ymaksime/closetLights/PV/data/characterization_1ft.xlsx

Setting voltage to 10V |  |  | Setting voltage to 11V |  |  | Setting voltage to 12V |  |  | Setting voltage to 13V |  |  | Setting voltage to 14V
DAC | Voltage V | Current A | DAC | Voltage V | Current A | DAC | Voltage V | Current A | DAC | Voltage V | Current A | DAC | Voltage V | Current A
1 | 9.999905 | 6.56425 | 1 | 11.00186 | 6.84726 | 1 | 12.00024 | 6.81325 | 1 | 12.99995 | 6.774538 | 1 | 14.00065 | 6.663732
2 | 10.00004 | 14.15017 | 2 | 11.00087 | 14.35725 | 2 | 12.00038 | 14.34969 | 2 | 13.00039 | 14.290668 | 2 | 14.0015 | 14.224782
3 | 10.00084 | 22.17305 | 3 | 11.00172 | 22.46013 | 3 | 12.00029 | 22.22919 | 3 | 13.00066 | 22.396928 | 3 | 14.00043 | 22.195312
4 | 10.00053 | 29.82993 | 4 | 11.00163 | 30.09426 | 4 | 12.00056 | 29.99044 | 4 | 13.00017 | 30.114478 | 4 | 14.00146 | 29.952502
5 | 10.00022 | 38.06347 | 5 | 11.00181 | 38.2133 | 5 | 11.9998 | 38.05394 | 5 | 12.99999 | 38.070998 | 5 | 14.00141 | 37.843062
6 | 9.999995 | 45.52778 | 6 | 11.00096 | 45.88562 | 6 | 11.9993 | 45.86493 | 6 | 13.00035 | 45.795398 | 6 | 14.00105 | 45.907942
7 | 10.00022 | 53.59571 | 7 | 11.00146 | 53.54335 | 7 | 11.99953 | 53.59111 | 7 | 13.00044 | 53.682588 | 7 | 14.00083 | 53.537062
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
