ymaksime/closetLights/hardware/simulations/bjt_analysis.asc

Q1: npn
R1: res; 1; tol=1 pwr=0.1
R2: res; 10K
R3: res; {R}
V1: voltage; PULSE(0 3.3 1 0.5 0.5 1 4 1)
V2: voltage; 12
Named nets: 0
.tran 10
.step param R 200 2K 100
