ymaksime/closetLights/hardware/simulations/constant_current_driver.asc

Q1: npn; FMMT458
Q2: npn; 2SCR564F3
R1: res; 1; tol=1 pwr=0.25
R2: res; 10K; tol=1 pwr=0.063
R3: res; 200; tol=1 pwr=0.063
R4: res; 55; tol=1 pwr=5
U1: AD712
V1: voltage; 15
V2: voltage; PULSE(0 0.2 1 0.5 0.5 2 4)
V3: voltage; 5
Named nets: 0
.tran 10
.MODEL FMMT458 NPN ( IS=5.32E-14 NF=1 BF=230 IKF=1.5 VAF=1500
    + ISE=2.1E-14 NE=1.385 NR=1.05 BR=8 IKR=0.7 VAR=64 ISC=6.42E-12
    + NC=1.25 RB=0.5 RE=0.224 RC=0.134 QUASIMOD=1 RCO=80 GAMMA=4E-7
    + CJC=9.5E-12 MJC=0.32 VJC=0.4 CJE=115E-12 MJE=0.37 VJE=0.8
    + TF=1.3E-9 TR=16E-6 TRC1=.004 TRB1=.004 TRE1=.004 XTB=1.4 )
In real circuit I used BUJ302AD for Q2.  I just could not find SPICE model for that BJT.
BUJ302AD: Ic = 4A, Vceo = 400V, Vebo = 24V, Ptot = 80W
In reality this Op-Amp will be inside a PIC uController
