ymaksime/closetLights/hardware/ledController/ledController.kicad_pcb

## KiCad design hardware/ledController/ledController.kicad_pcb (2023-01-10)

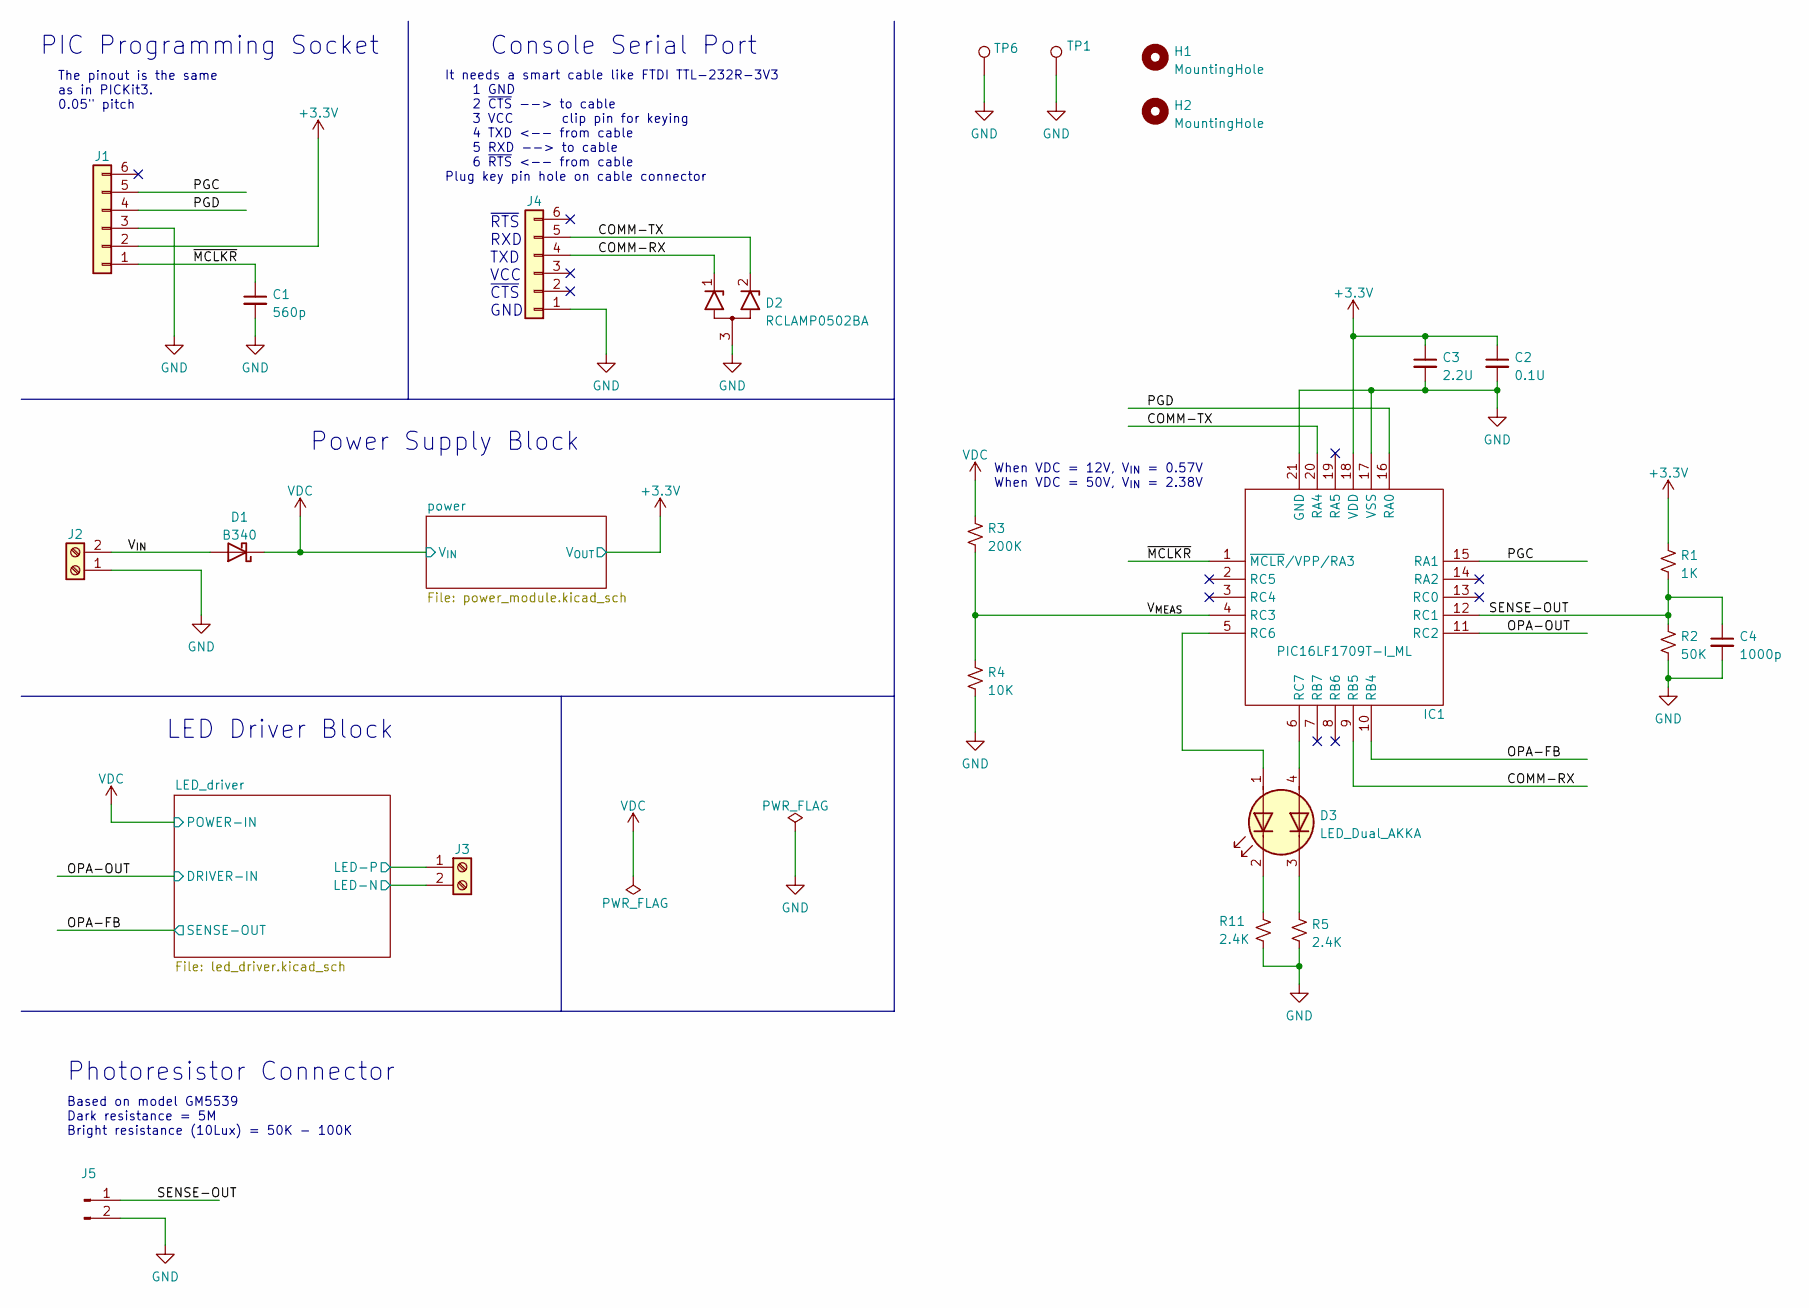
[picture p1: schematic ledController.kicad_sch, Lantern]

Parts:
C1: 560p; C_0402_1005Metric_Pad0.74x0.62mm_HandSolder
C2: 0.1U; C_0402_1005Metric_Pad0.74x0.62mm_HandSolder
C3: 2.2U; C_0402_1005Metric_Pad0.74x0.62mm_HandSolder
C4: 1000p; C_0402_1005Metric_Pad0.74x0.62mm_HandSolder
D1: B340; D_SMA
D2: RCLAMP0502BA; SC-75
D3: LED_Dual_AKKA; LED_Kingbright_APHBM2012_2x1.25mm
H1, H2: MountingHole; MountingHole_2.5mm_Pad_TopBottom
IC1: PIC16LF1709T-I_ML; QFN-20-1EP_4x4mm_P0.5mm_EP2.5x2.5mm
J1: Conn_01x06; PinHeader_1x06_P1.27mm_Vertical
J2, J3: Screw_Terminal_01x02; TerminalBlock_Altech_AK300-2_P5.00mm
J4: Conn_01x06; PinHeader_1x06_P2.54mm_Vertical
J5: Conn_01x02_Male; PinSocket_1x02_P2.54mm_Vertical
R1: 1K; R_0603_1608Metric_Pad0.98x0.95mm_HandSolder
R2: 50K; R_0603_1608Metric_Pad0.98x0.95mm_HandSolder
R3: 200K; R_0603_1608Metric_Pad0.98x0.95mm_HandSolder
R4: 10K; R_0603_1608Metric_Pad0.98x0.95mm_HandSolder
R5, R11: 2.4K; R_0603_1608Metric_Pad0.98x0.95mm_HandSolder
TP1, TP6: TestPoint; TestPoint_Pad_0.185in_x_0.135in

Connections:
+3.3V: C2.1, C3.1, IC1.18 (VDD), J1.2, R1.1; also elsewhere on the board
/COMM-RX: D2.1 (K1), IC1.9 (RB5), J4.4
/COMM-TX: D2.2 (K2), IC1.20 (RA4), J4.5
/LED_driver/LED-N: J3.2; also elsewhere on the board
/OPA-FB: IC1.10 (RB4); also elsewhere on the board
/OPA-OUT: IC1.11 (RC2); also elsewhere on the board
/PGC: IC1.15 (RA1), J1.5
/PGD: IC1.16 (RA0), J1.4
/SENSE-OUT: C4.1, IC1.12 (RC1), J5.1, R1.2, R2.1
/V_{IN}: D1.2 (A), J2.2
/V_{MEAS}: IC1.4 (RC3), R3.2, R4.1
/~MCLKR: C1.1, IC1.1 (~MCLR/VPP/RA3), J1.1
GND: C1.2, C2.2, C3.2, C4.2, D2.3 (A), IC1.17 (VSS), IC1.21 (GND), J1.3, J2.1, J4.1, J5.2, R2.2, R4.2, R5.2, R11.2, TP1.1, TP6.1; also elsewhere on the board
unnamed: D3.1 (A1), IC1.5 (RC6)
unnamed: D3.2 (K1), R11.1
unnamed: D3.3 (K2), R5.1
unnamed: D3.4 (A2), IC1.6 (RC7)
VDC: D1.1 (K), J3.1, R3.1; also elsewhere on the board

Notes on the sheet:
Photoresistor Connector
It needs a smart cable like FTDI TTL-232R-3V3 1 GND 2 ~{CTS} --> to cable 3 VCC clip pin for keying 4 TXD <-- from cable 5 RXD --> to cable 6 ~{RTS} <-- from cable Plug key pin hole on cable connector
~{RTS} RXD TXD VCC ~{CTS} GND
Power Supply Block
PIC Programming Socket
Console Serial Port
The pinout is the same as in PICKit3. 0.05" pitch
When VDC = 12V, V_{IN} = 0.57V When VDC = 50V, V_{IN} = 2.38V
Based on model GM5539 Dark resistance = 5M Bright resistance (10Lux) = 50K - 100K
LED Driver Block

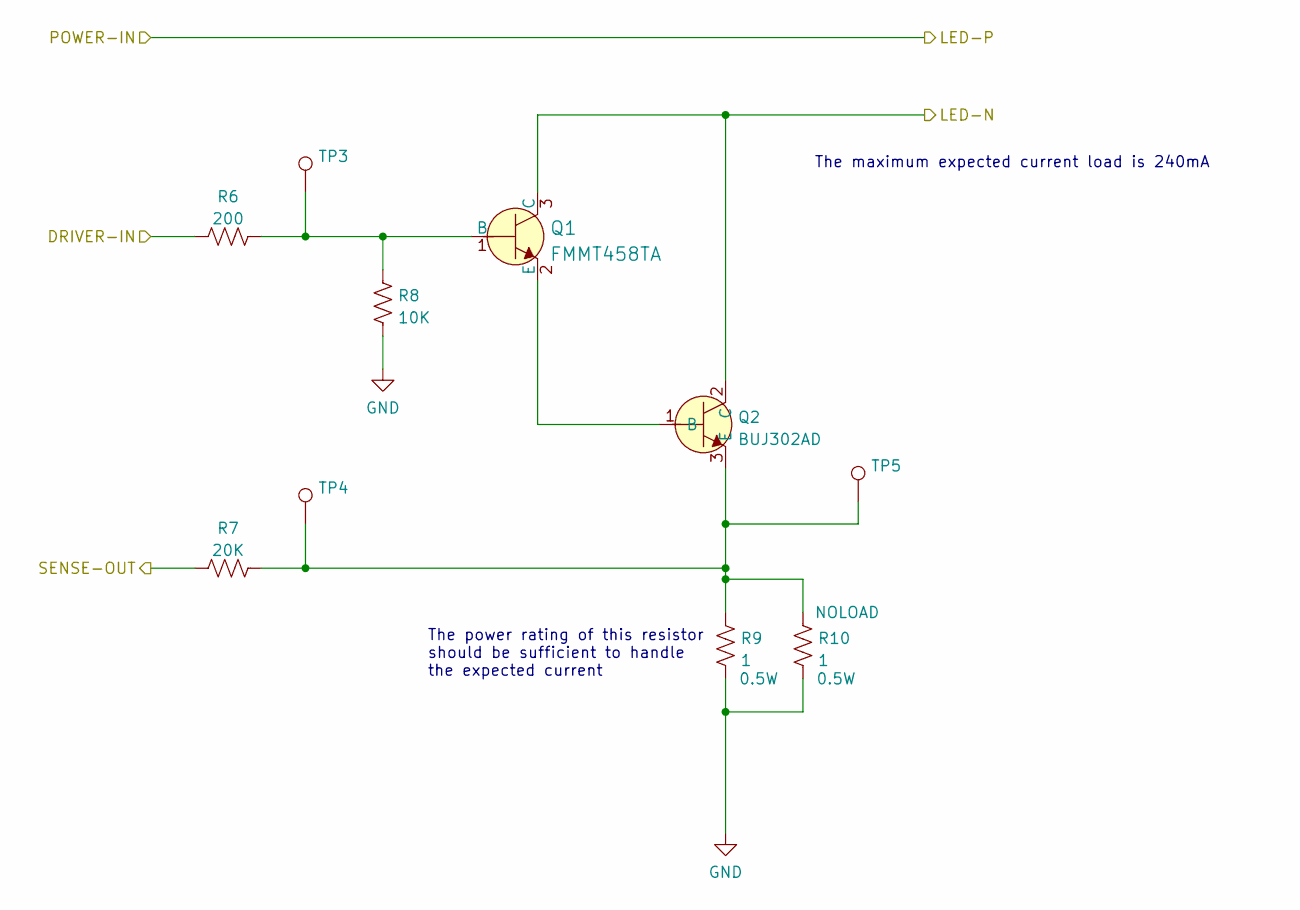
[picture p2: schematic led_driver.kicad_sch, Lantern]

Parts:
Q1: FMMT458TA; SOT-23-3; MPN FMMT458TA; Digi-Key_PN FMMT458CT-ND
Q2: BUJ302AD; SOT-428
R6: 200; R_0603_1608Metric_Pad0.98x0.95mm_HandSolder
R7: 20K; R_0603_1608Metric_Pad0.98x0.95mm_HandSolder
R8: 10K; R_0603_1608Metric_Pad0.98x0.95mm_HandSolder
R9, R10: 1; R_1206_3216Metric_Pad1.30x1.75mm_HandSolder
TP3, TP4, TP5: TestPoint; TestPoint_Pad_D1.5mm

Connections:
/LED_driver/LED-N: Q1.3 (C), Q2.2 (C); also elsewhere on the board
/OPA-FB: R7.1; also elsewhere on the board
/OPA-OUT: R6.1; also elsewhere on the board
GND: R8.2, R9.2, R10.2; also elsewhere on the board
unnamed: Q1.1 (B), R6.2, R8.1, TP3.1
unnamed: Q1.2 (E), Q2.1 (B)
unnamed: Q2.3 (E), R7.2, R9.1, R10.1, TP4.1, TP5.1

Notes on the sheet:
The maximum expected current load is 240mA
The power rating of this resistor should be sufficient to handle the expected current

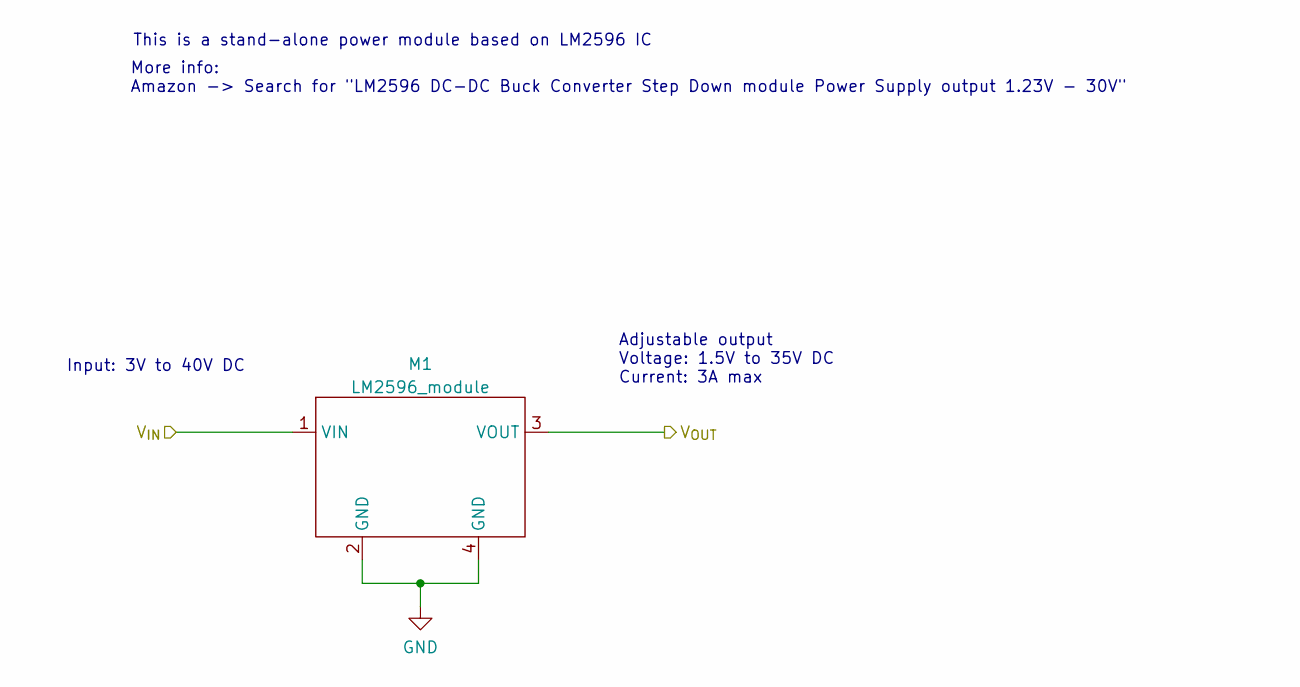
[picture p3: schematic power_module.kicad_sch]

Parts:
M1: LM2596_module

Connections:
+3.3V: M1.3 (VOUT); also elsewhere on the board
GND: M1.2 (GND), M1.4 (GND); also elsewhere on the board
VDC: M1.1 (VIN); also elsewhere on the board

Notes on the sheet:
Adjustable output Voltage: 1.5V to 35V DC Current: 3A max
Input: 3V to 40V DC
This is a stand-alone power module based on LM2596 IC
More info: Amazon -> Search for "LM2596 DC-DC Buck Converter Step Down module Power Supply output 1.23V - 30V"

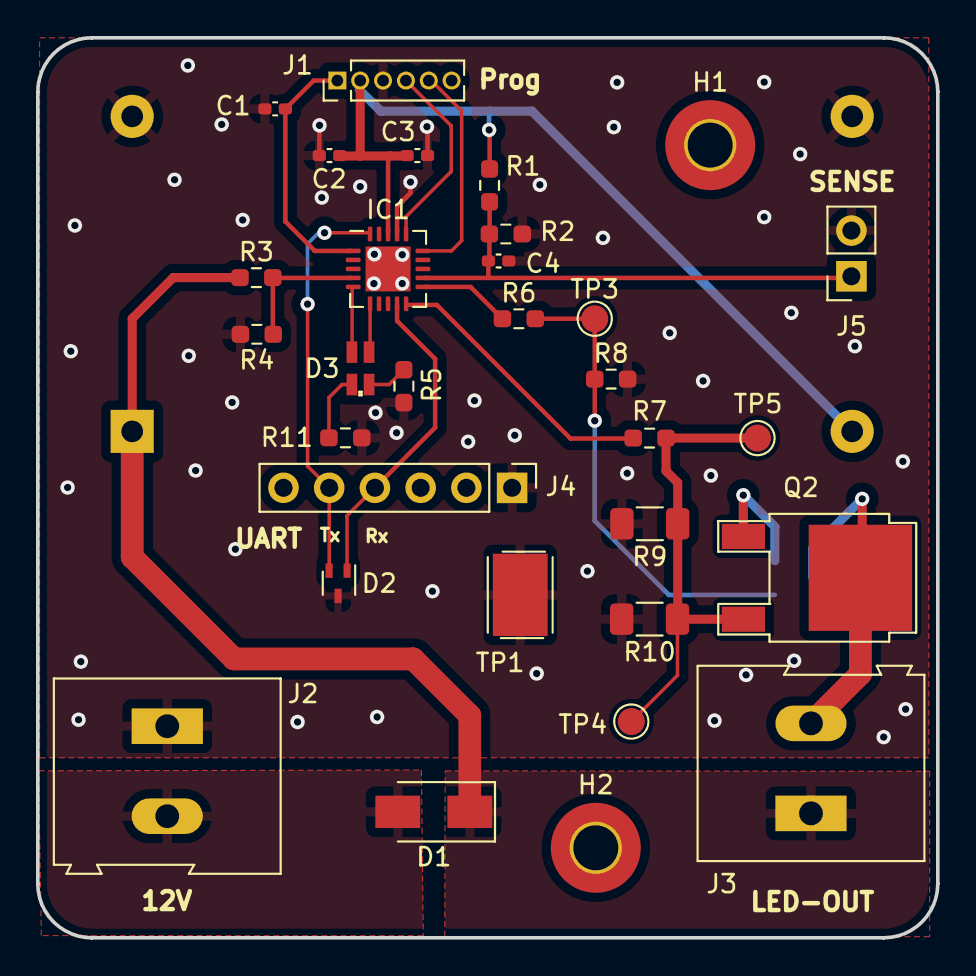
[picture p4: board ledController.kicad_pcb from above]

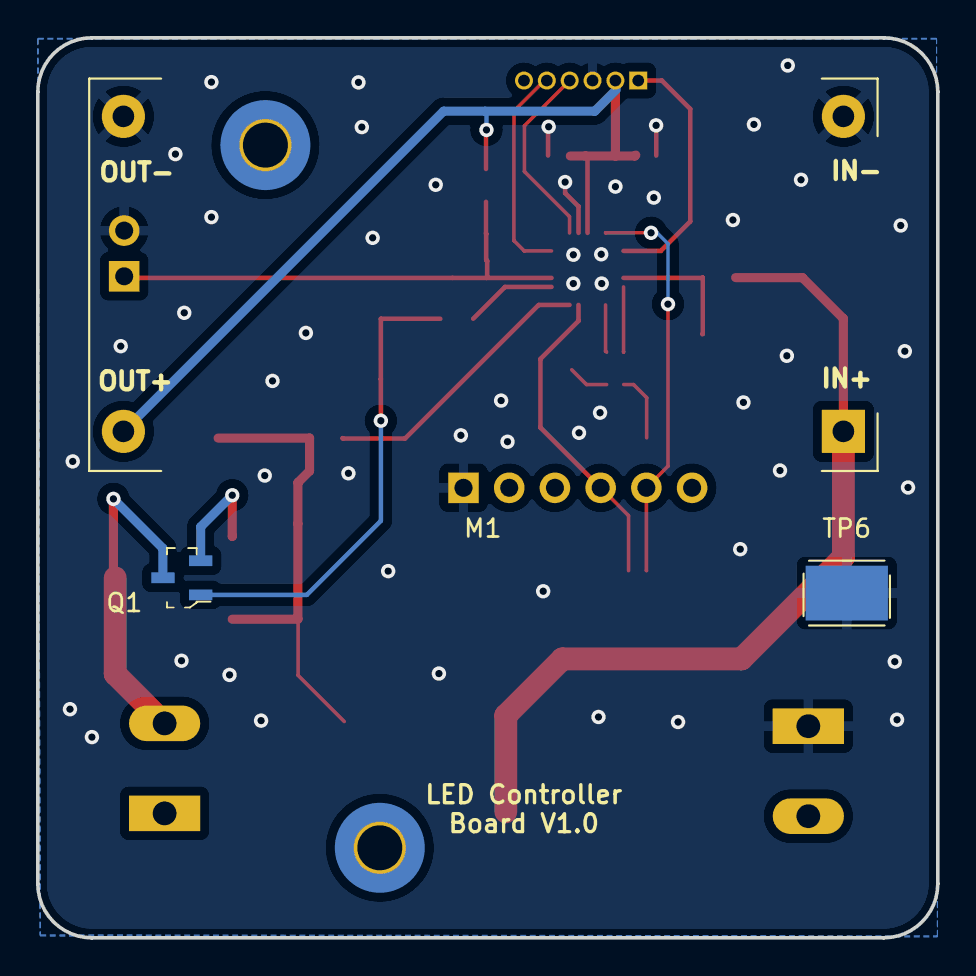
[picture p5: board ledController.kicad_pcb from below]

Board: 2 copper layers, 50.0 x 50.0 mm, 34 parts (3 on the bottom side), 21 nets.
