ymaksime/closetLights/firmware/pic-led-controller.X/version.h

/* 
 * File:   version.h
 * Author: ymaksime
 *
 * Created on January 10, 2023, 3:53 PM
 */

#ifndef VERSION_H
#define	VERSION_H

#ifdef	__cplusplus
extern "C" {
#endif

#define VERSION "Va_1.0"


#ifdef	__cplusplus
}
#endif

#endif	/* VERSION_H */
