ymaksime/closetLights/(commit log)

2022-09-26 initial board checkin
    [ledController.kicad_pcb, ledController.kicad_sch]
2022-10-06 Some technical info about the LED strip light
2022-10-06 Added two more schematic pages
    [led_driver.kicad_sch, power.kicad_sch]
2022-10-07 Updated max LED current
2022-10-07 Added LTSpice simulations current driver
2022-10-07 Added theoretical ON resistance at max current
2022-10-14 Added new schematic page for led current driver
    [led_driver.kicad_sch]
2022-10-14 Incorporated the led driver to the main design
    [ledController.kicad_sch]
2022-10-21 Added serial comm
    [ledController.kicad_sch]
2022-10-27 Renamed and modified power sheet
    [power.kicad_sch, power_12V.kicad_sch]
2022-10-27 Added one more design for 3.3V switcher
    [power_3p3V.kicad_sch]
2022-10-27 Some cleanup
    [power_3p3V.kicad_sch]
2022-10-27 Added BJT base resistor and some cleanup
    [led_driver.kicad_sch]
2022-10-27 Putting everything together
    [ledController.kicad_sch]
2022-11-01 Added NOLOAD resistor R10
    [led_driver.kicad_sch]
2022-12-21 Added new schematic for power module
    [power_module.kicad_sch]
2022-12-21 First attempt of schematic to PCB
    [ledController.kicad_pcb, ledController.kicad_sch, led_driver.kicad_sch, power_3p3V.kicad_sch]
2022-12-29 More schematic updates
    Moved from PIR sensor to photoresistor + additional components
    Added mounting holes
    Moved to a stand alone 3.3V switcher
    [ledController.kicad_sch, led_driver.kicad_sch, power_module.kicad_sch]
2022-12-29 PCB work
    [ledController.kicad_pcb]
2022-12-29 Minor changes
    [ledController.kicad_pcb]
2022-12-29 Changed R9 and R10 to use 1206
    [led_driver.kicad_sch]
2022-12-29 Replaced debug LED
    [ledController.kicad_sch]
2022-12-30 modified footprint for D1
    [ledController.kicad_sch]
2022-12-30 Replaced footprint of D2
    [ledController.kicad_sch]
2022-12-30 Changed based on the footprint updates
    [ledController.kicad_pcb]
2023-01-09 Device change
    Changed from PIC16F1769 to PIC16LF1709
2023-01-10 Version V1.1
    Replaced PIC16F1769 with PIC16LF1709. They are pin-to-pin
    compatible with each other
    [ledController.kicad_pcb, ledController.kicad_sch]
2023-04-05 Added support for RS232 communication
    Also added a few function to control LEDs and read ADC channels
    for sensor and +12V voltage
2023-04-05 Fixed the note for Serial Port connector
    [ledController.kicad_sch]
2023-04-05 Changed R1 from 1K to 15K
    Based on the experiments, R1 needs to be close to 15K
    [ledController.kicad_sch]
2023-04-12 Added support for ADC read functions
    Added the following RS232 functions
    ADC5
    * Sets channel 5 as an active ADC channel
    * This channel measure SENSOR-OUT signal, which is photo-resistor
    output
    ADC7
    * Set channel 7 as an active ADC channel
    * This channel measures Vmeas signal, which is the input voltage to the
    module
    ADCR
    * Returns averaged and rounded down value of last 8 (for now) ADC
    samples on the active channel
    VERG
    * Returns current Firmware version
2023-08-31 Added DAC control functions
    DACS
    Allows a user to set DAC to a specific value through RS232 interface.
    The value must be in decimal format and should not exceed 8-bit value
    If larger than an 8-bit value, it will be truncated
    Expected command format: DACS XXX
    DACR
    Allows a user to quiry the current DAC value
    Output is an 8-bit value that the DAC is currently set to
2023-08-31 Function name change
    Renamed "read_millivolts()" to "adc_read" since it is just averaged out
    ADC reading
2023-09-06 Bug fix
    There was a typo which resulted in setting a wrong baud rate. Also
    removed unused code
    [pic_driver.py]
2023-09-06 New commands and bug fixes
    Fixed read and write function based on the experiments
    Added control for ECHO command
    Added DAC set command
    Improved comments to include formulas
    [pic_driver.py]
2023-09-13 Modifications to the generated DAC file
    By default if the DAC is set to 0, the OP-AMP is still sourcing a small
    amount of current which slightly turns On the external transistor.
    Therefore, if zero is requested, convert the OP-AMP into a follower to
    eliminate the problem
    [adc_control.h]
2023-09-13 Added formula for DAC-Current relationship
2023-09-13 Moved LED related code into a separate file
2023-09-13 Improved ADC channel selection mechanism
2023-09-19 Added comments
    [led_driver.kicad_sch]
2023-09-19 Random files
    [characterization_1ft.xlsx]
